vaggstamp/AAIS/AAISpcb-assembled.jpg

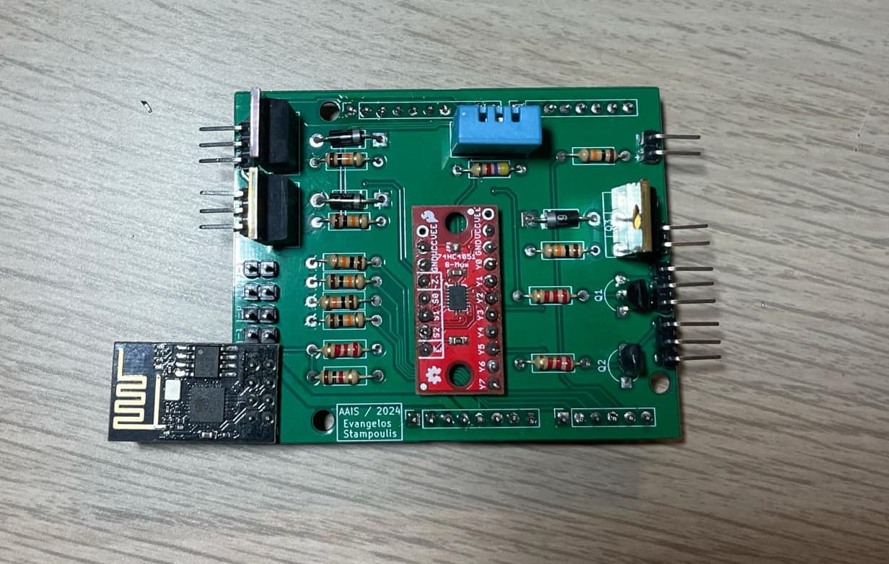
AAISpcb-assembled.jpg
