vaggstamp/AAIS/AAISpcb-comp.jpg

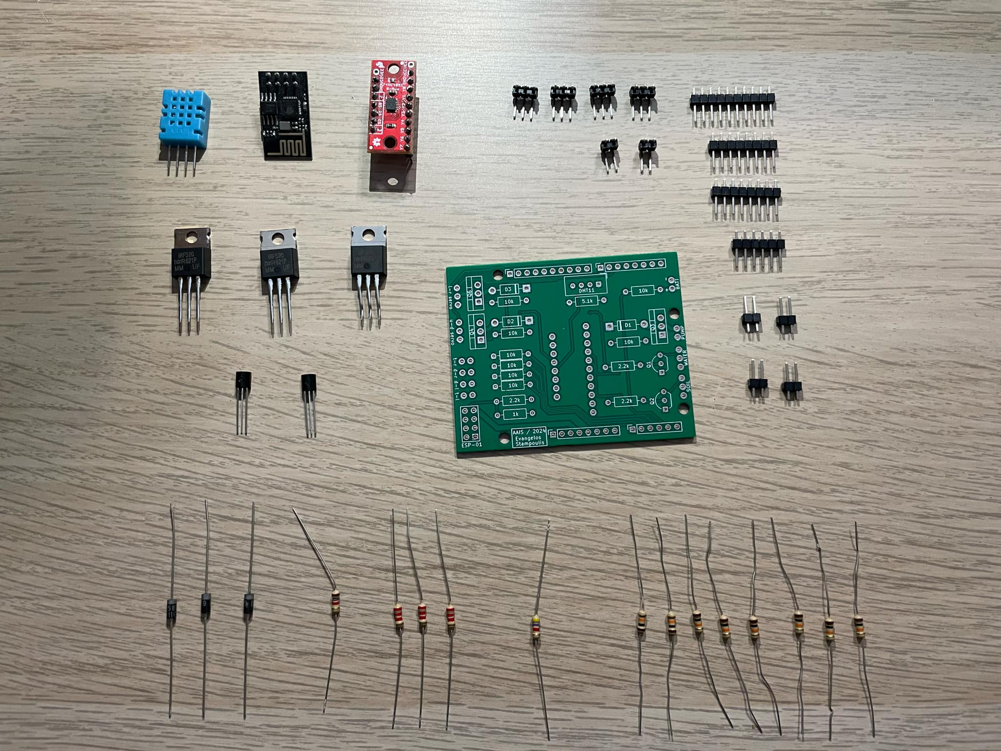
AAISpcb-comp.jpg
